pinnet/RC6502-Apple-1-Replica/RC6502 Terminal/rescue-backup/RC6502 Terminal-2021-03-13-13-56-54.sch

## KiCad design RC6502 Terminal/rescue-backup/RC6502 Terminal-2021-03-13-13-56-54.sch (2021-03-17)

Schematic: RC6502 Terminal-2021-03-13-13-56-54.sch

Parts:
C1, C2, C3, C4, C5, C7, C8: 100nF; C_Disc_D4.7mm_W2.5mm_P5.00mm
C6, C10, C11, C12: 22pF; C_Disc_D4.7mm_W2.5mm_P5.00mm
C9: 10nF; C_Disc_D4.7mm_W2.5mm_P5.00mm
D1, D2: 1n4148; D_DO-35_SOD27_P7.62mm_Horizontal
D3: VID; LED_D5.0mm
D4: KBD; LED_D5.0mm
J1: RC6502_Backplane; Pin_Header_Angled_1x39_Pitch2.54mm
J2: KBD_SER; Pin_Header_Straight_1x06_Pitch2.54mm
J3: VID_SER; Pin_Header_Straight_1x06_Pitch2.54mm
J4: KBD_ICSP; Pin_Header_Straight_2x03_Pitch2.54mm
J5: VID_ICSP; Pin_Header_Straight_2x03_Pitch2.54mm
J6: AUDIO; rca_yellow
J7: VIDEO; rca_yellow
J8: Keyboard; MINI-DIN-6-FULL-SHIELD
JP1: KBD_PWR; Pin_Header_Straight_1x02_Pitch2.54mm
JP2: VID_PWR; Pin_Header_Straight_1x02_Pitch2.54mm
JP3: SELECT; Pin_Header_Straight_1x03_Pitch2.54mm
R1, R2, R8, R9: 10k; R_Axial_DIN0207_L6.3mm_D2.5mm_P10.16mm_Horizontal
R3: 1k; R_Axial_DIN0207_L6.3mm_D2.5mm_P10.16mm_Horizontal
R4: 330; R_Axial_DIN0207_L6.3mm_D2.5mm_P10.16mm_Horizontal
R5: 75; R_Axial_DIN0207_L6.3mm_D2.5mm_P10.16mm_Horizontal
R6, R7: 220; R_Axial_DIN0207_L6.3mm_D2.5mm_P10.16mm_Horizontal
SW1: KBD_RES; SW_PUSH_6mm
SW2: VID_RES; SW_PUSH_6mm
U1: MC6821; DIP-40_W15.24mm_Socket_LongPads
U2: 74LS138; DIP-16_W7.62mm_Socket_LongPads
U3: 74LS00; DIP-14_W7.62mm_Socket_LongPads
U4, U5: ATMEGA328_MCU; DIP-28_W7.62mm_Socket
Y1, Y2: 16Mhz; Crystal_HC49-4H_Vertical

Notes on the sheet:
RC6502 Terminal
Implements the Apple1 video and keyboard input section, but uses two Atmega328s in place of the original hardware while working somewhat like two separate Arduino on the board.
Address decoding places PIA at the expected addresses $D010 to $D012, these registers are mirrored across the entire $Dxxx range. SELECT should be on 1-2, 2-3 is used if this card should instead be placed on $D000 to $D002 (for debugging).
