pinnet/RC6502-Apple-1-Replica/RC6502 VDU/rescue-backup/RC6502 VDU-2021-03-06-23-37-49.sch

## KiCad design RC6502 VDU/rescue-backup/RC6502 VDU-2021-03-06-23-37-49.sch (2021-03-10)

Schematic: RC6502 VDU-2021-03-06-23-37-49.sch

Parts:
C1, C2, C3, C4, C5, C6, C7, C8, C9, C10, C12: 100nF; C_Disc_D4.7mm_W2.5mm_P5.00mm
J1: RC6502_Backplane; Pin_Header_Angled_1x39_Pitch2.54mm
J2: VDU_BASE; Pin_Header_Straight_2x07_Pitch2.54mm
J3: VIDEO; Pin_Header_Straight_1x07_Pitch2.54mm
J4, J5, J6, J7: Hole; Mounting
J8: RCA_PLUG; rca_yellow
JP1: VDU_EN; Pin_Header_Straight_1x02_Pitch2.54mm
JP2: OSC_EN; Pin_Header_Straight_1x02_Pitch2.54mm
JP3: INT_ON_FS; Pin_Header_Straight_1x02_Pitch2.54mm
JP4: CSS_SEL; Pin_Header_Straight_1x03_Pitch2.54mm
JP5: INV_SEL; Pin_Header_Straight_1x03_Pitch2.54mm
U1: MC6847; DIP-40_W15.24mm_Socket
U2: HM62256BLP-7; DIP-28_W15.24mm_Socket
U3, U4: 74LS244; DIP-20_W7.62mm_Socket
U5: 74LS245; DIP-20_W7.62mm_Socket
U6, U12: 74LS374; DIP-20_W7.62mm_Socket
U7, U9: 74HCT138; DIP-16_W7.62mm_Socket
U8: 74LS32; DIP-14_W7.62mm_Socket
U10: 74LS08; DIP-14_W7.62mm_Socket
U11: VDU_Port; Amplifier
X1: 3.579545 MHz; Oscillator_DIP-14

Notes on the sheet:
RC6502 Apple 1 SBC
ROM
$C000
$B000
$A000
$9000
$8000
Disable VDU when accessed externally
Display adapter based on the Motorola 6847 Video Display Generator (VDG), this maps into the memory space and does not follow the designs of the Apple 1 computer, instead it is only intended for use with the RC6502 computer.
$D000
$E000
