pinnet/RC6502-Apple-1-Replica/(commit log)

2021-03-10 my commit of autogen updates
    [RC6502 Apple 1 SBC-2021-03-05-13-52-26.sch, RC6502 Apple 1 SBC-2021-03-06-23-46-15.sch, RC6502 Apple 1 SBC-2021-03-09-06-24-56.sch, RC6502 VDU-2021-03-06-23-37-49.sch]
2021-03-10 Fixed dowload types hex asm bas
    [RC6502 Apple 1 SBC-2021-03-10-19-27-02.sch, RC6502 Apple 1 SBC.sch]
2021-03-17 Update Kicad libs
    [RC6502 PSG-2021-03-13-13-37-36.sch, RC6502 PSG.sch, RC6502 Terminal-2021-03-13-13-56-54.sch]
